hhintoglu/Analog_Air_Conditioner_System/README.md

# Analog_Air_Conditioner_System
Repo for Analog Air Conditioner System Project
