hhintoglu/Analog_Air_Conditioner_System/Simulations/213-project-neartheend.asc

C1: cap; 100n
C2: cap; 20µ
C3: cap; 20µ
D1: diode
D2: diode
D3: LED; blue
D4: LED; red
D5: LED; green
fan: res2; 100
Q1: npn; BD135
Q2: npn; BD135
R1: res; 1k
R2: res; 7k
R3: res; 1k
R4: res; 3k
R5: res; 2.2k
R6: res; 22.6k
R7: res; 1k
R8: res; 2.2k
R9: res; 1k
R10: res; 1k
R11: res; 1.8k
R12: res; 1k
R13: res; 1k
R14: res; 35k
R15: res; 35k
R16: res; 1k
R17: res; 35k
R18: res; 1k
R19: res; 35k
R20: res; 1k
R21: res; 1.8k
R22: res; 1.8k
R23: res; 1k
stone: res2; 100
U1: UniversalOpamp2
U2: UniversalOpamp2
U3: UniversalOpamp2
U4: UniversalOpamp2
U5: UniversalOpamp2
V5: voltage; 12
V6: voltage; 12
V7: voltage; 12
V8: voltage; -12
V9: voltage; -12
V10: voltage; 0.25
V13: voltage; 12
V14: voltage; 0.25
Vcc1: voltage; 12
Vcc2: voltage; -12
Vcc: voltage; -12
Vdd1: voltage; 12
Vdd2: voltage; -12
Vdd: voltage; -12
Named nets: 0
.tran 0 1.01 1 uic
Rectangular wave obtained
in the first part
The DC value coming
from part b
DC output coming from 
temperature adjustment unit
DC value coming from
ensing unit
DC output coming from 
temperature adjustment unit
DC value coming from
ensing unit
TEMPERATURE ADJUSTMENT UNIT
SENSING UNIT
DECISION SUBUNIT
FUNCTION SUBUNIT
CONTROL UNIT
