hhintoglu/Analog_Air_Conditioner_System/Simulations/Draft1.asc

C1: cap; 100n
C2: cap; 150n
C3: cap; 150n
D1: diode
D2: diode
D3: LED; blue
D4: LED; red
D5: LED; green
fan: res2; 100
Q1: npn; BD135
Q2: npn; BD135
R1: res; 1k
R2: res; 2k
R3: res; 1k
R4: res; 8k
R5: res; 2.2k
R6: res; 36.3k
R7: res; 1.8k
R8: res; 2.2k
R9: res; 1k
R10: res; 36.3k
R11: res; 1k
R12: res; 36.3k
R13: res; 1k
R14: res; 1k
R15: res; 1k
R16: res; 1k
R17: res; 36.3k
R18: res; 36.3k
R19: res; 22k
R20: res; 22k
R21: res; 1k
R22: res; 1k
R23: res; 1.8k
R24: res; 1.8k
stone: res2; 6.8
U1: UniversalOpamp2
U2: UniversalOpamp2
U3: UniversalOpamp2
U4: UniversalOpamp2
U5: UniversalOpamp2
U6: UniversalOpamp2
V1: voltage; -12
V2: voltage; -12
V4: voltage; 12
V5: voltage; 12
V6: voltage; 12
V7: voltage; 12
V9: voltage; 12
Vcc1: voltage; -12
Vcc2: voltage; -12
Vcc3: voltage; 12
Vcc4: voltage; -12
Vdd1: voltage; -12
Vdd2: voltage; -12
Vdd3: voltage; 12
Vdd4: voltage; -12
Named nets: 0
.tran 0 1.01 1 uic
Rectangular wave obtained
in the first part
The DC value coming
from part b
TEMPERATURE ADJUSTMENT UNIT
DECISION SUBUNIT
FUNCTION SUBUNIT
CONTROL UNIT
DC output coming from 
temperature adjustment unit
DC output coming from 
temperature adjustment unit
DC value coming 
from sensing unit
DC value coming 
from sensing unit
Output of U5
Output of U3
