hhintoglu/Analog_Air_Conditioner_System/Simulations/WARNING.asc

C1: cap; 1µ
C2: cap; 470n
C3: cap; 100µ
R1: res; 1.8k
R2: res; 2.2k
R3: res; 1.2k
R4: res; 2k
R5: res; 1.2k
R6: res; 2.2k
U4: UniversalOpamp2
U5: UniversalOpamp2
U6: UniversalOpamp2
V1: voltage; 12
V2: voltage; 12
V3: voltage; 0.01
V4: voltage; 12
V5: voltage; 12
V6: voltage; 6
V7: voltage; 12
V8: voltage; 12
Named nets: 0
.tran 0 0.51 0.5
